shichaochen/bird-nest-temp/egg_model/egg_bottom.stl

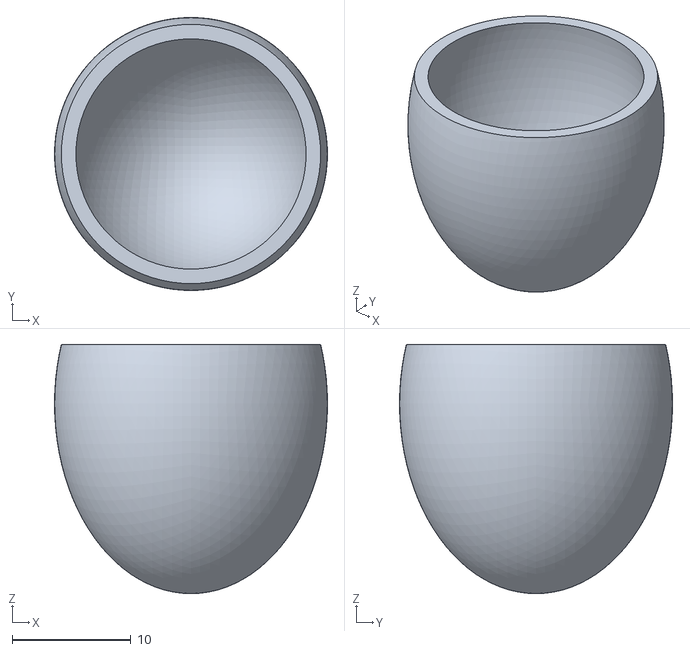
[picture p1: CAD file, 2026-11-07]
egg_model/egg_bottom.stl
23.0 x 23.0 x 21.0
