shichaochen/bird-nest-temp/egg_model/egg_top.stl

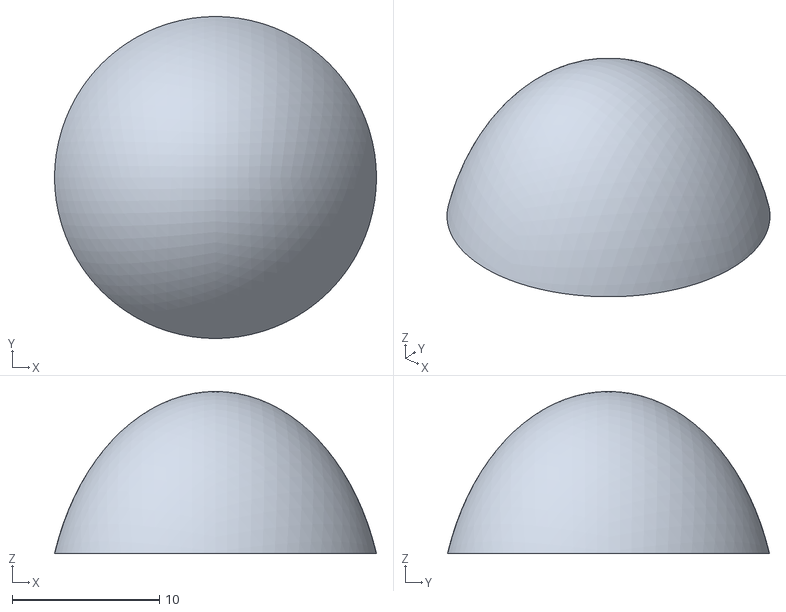
[picture p2: CAD file, 2026-11-07]
egg_model/egg_top.stl
21.8 x 21.8 x 11.0
